Tinkerforge/co2-v2-bricklet/hardware/co2-v2.FCStd

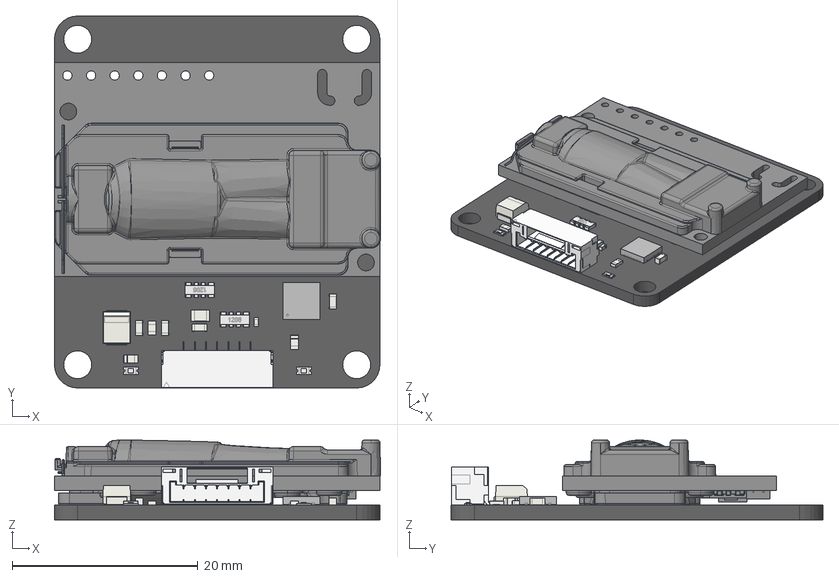
[picture p1: CAD file, 2019-05-15]
hardware/co2-v2.FCStd
35.1 x 40.0 x 8.60 mm
Pcb
R2_R_0603_5BA03E73
R1_R_0603_5BA03E6A
C2_C_0805_5B9F7B11
C3_C_0603_5B9F7B1B
D1_D_0603_blue_5B9F7B59
C1_C_0402_5B9F7B07
C4_C_0603_5B9F7B25
C5_C_0603_5B9F7B2F
C6_C_0603_5B9F7B39
C7_Tantalum_B_3528H21_5B9F9A73
D2_D_0603_blue_5B9F7B6A
L1_R_0603_5B9F7B74
P1_BrickletConn_7pin_5BA0D92D
RP1_R_4x0603_5B9F7BA5
RP3_R_4x0603_5B9F9CCB
U1_QFN-24_4x4mm_Pitch0.5mm_5B9F7BEA
U6_SCD30_5B9F8BF0
