Tinkerforge/co2-v2-bricklet/hardware/co2-v2-schematic.pdf

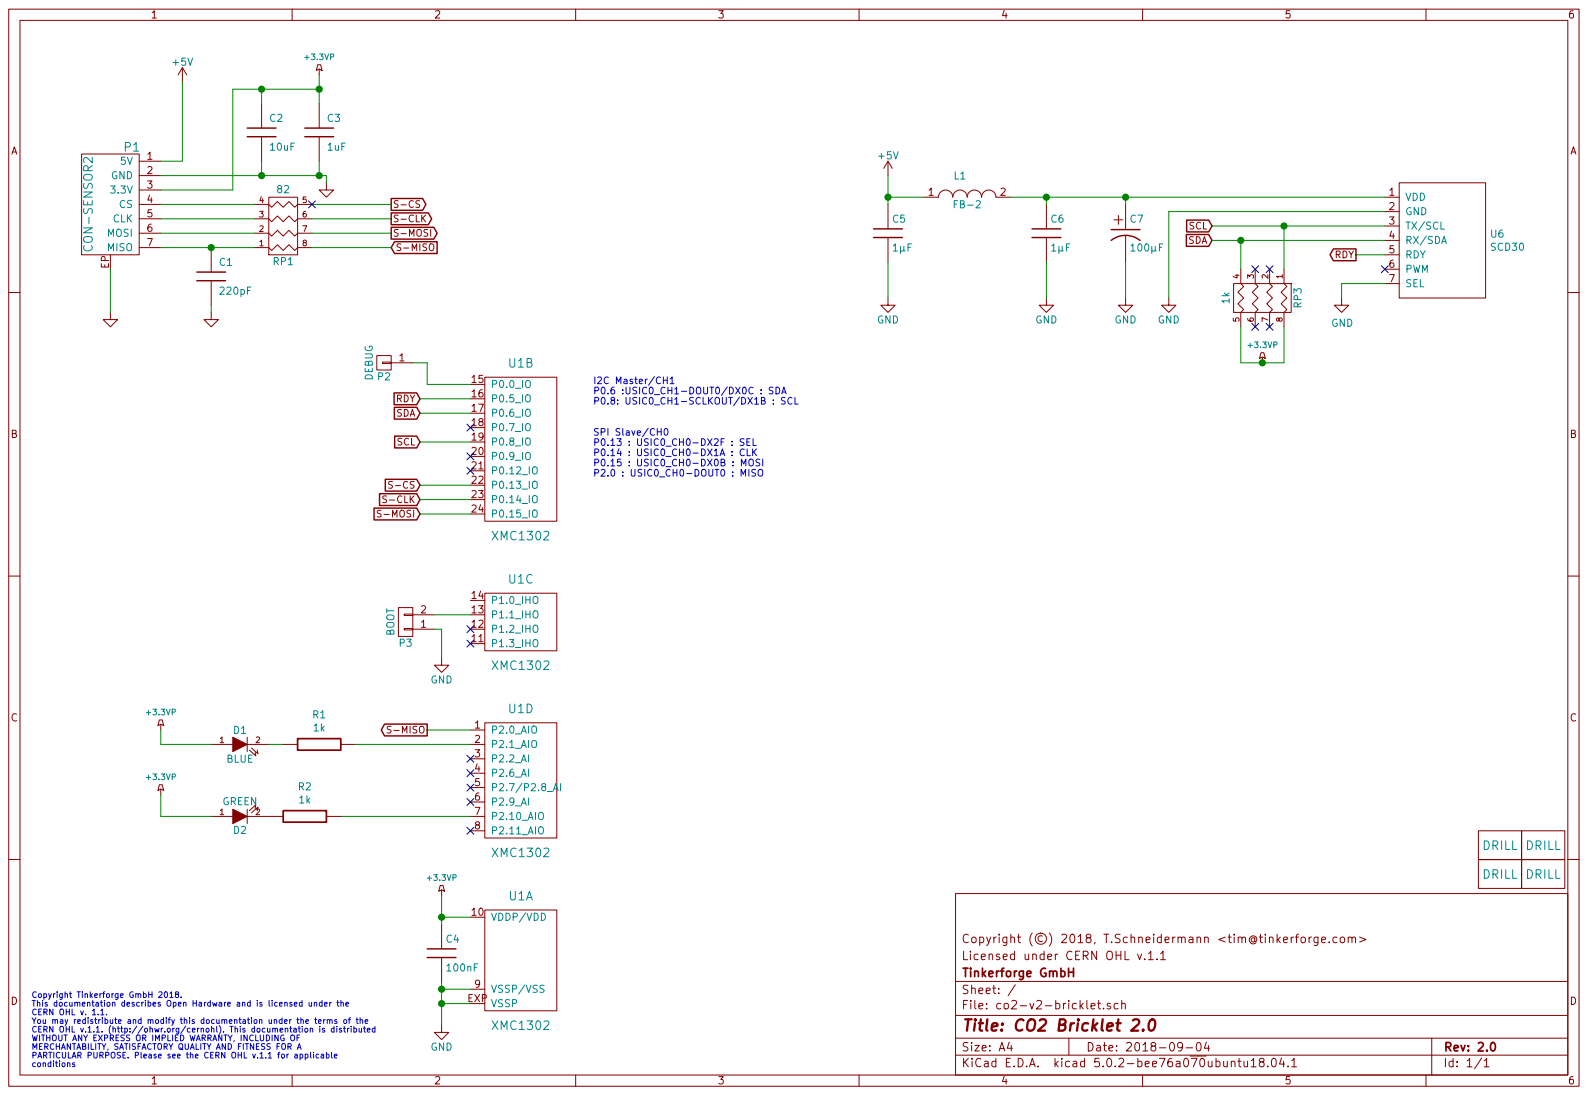
[picture p2: page 1]

SCL SDA GND GND

P0.8: USIC0_CH1-SCLKOUT/DX1B : SCL Copyright Tinkerforge GmbH 2018. This documentation describes Open Hardware and is licensed under the CERN OHL v. 1.1. You may redistribute and modify this documentation under the terms of the CERN OHL v.1.1. (http://ohwr.org/cernohl). This documentation is distributed WITHOUT ANY EXPRESS OR IMPLIED WARRANTY, INCLUDING OF MERCHANTABILITY, SATISFACTORY QUALITY AND FITNESS FOR A

SPI Slave/CH0 P0.13 : USIC0_CH0-DX2F : SEL P0.14 : USIC0_CH0-DX1A : CLK

Licensed under CERN OHL v.1.1 Copyright (©) 2018, T.Schneidermann <tim@tinkerforge.com>

File: co2-v2-bricklet.sch Sheet: / Tinkerforge GmbH

PARTICULAR PURPOSE. Please see the CERN OHL v.1.1 for applicable
conditions
