Tinkerforge/co2-v2-bricklet/hardware/co2-v2.kicad_pcb

## KiCad design hardware/co2-v2.kicad_pcb (2019-05-09)

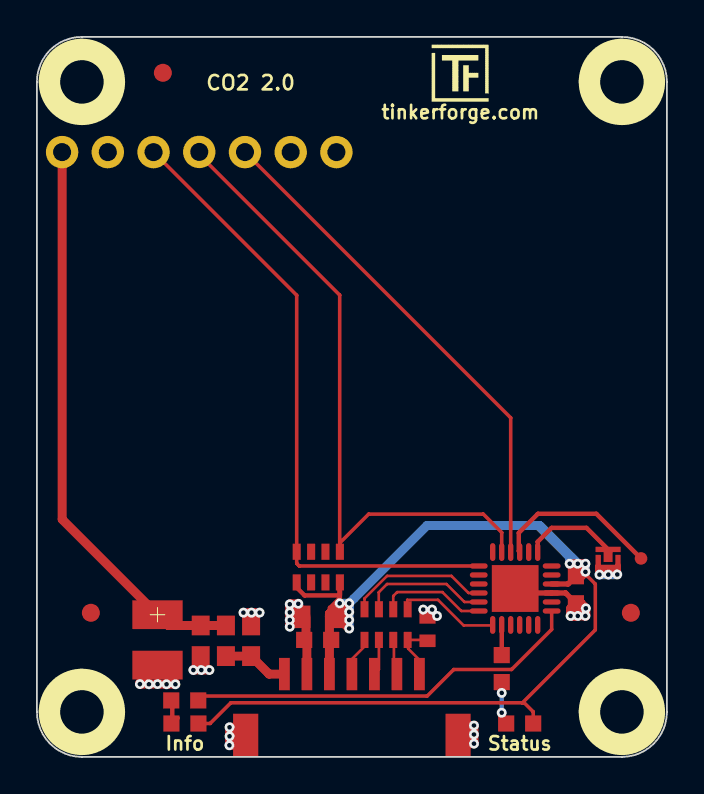
[picture p3: board co2-v2.kicad_pcb from above]

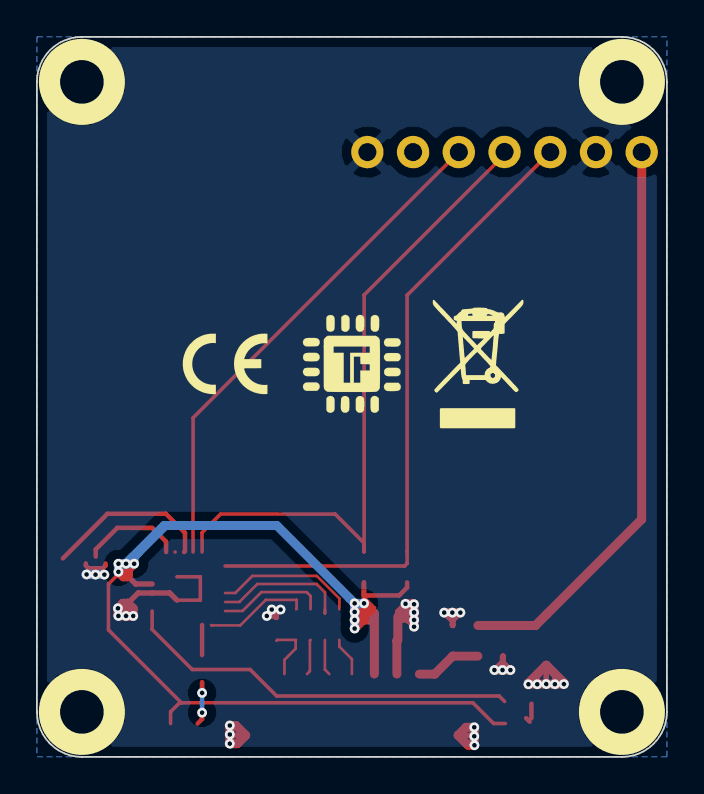
[picture p4: board co2-v2.kicad_pcb from below]

Board: 2 copper layers, 35.0 x 40.0 mm, 28 parts (2 on the bottom side), 21 nets.

Parts:
C1: 220pF; C0402E
C2: 10uF; C0805
C3: 1uF; C0603F
C4: 100nF; C0603F
C5, C6: 1µF; C0603E
C7: 100µF; 3528-21
D1: BLUE; D0603F
D2: GREEN; D0603F
Fiducial_Mark: VAL**; Fiducial_Mark
Fiducial_Mark#2, Fiducial_Mark#3: VAL**; Fiducial_Mark
L1: FB-2; R0603E
P1: CON-SENSOR2
P2: DEBUG; DEBUG_PAD
P3: BOOT; SolderJumper
R1, R2: 1k; R0603F
RP1: 82; 4X0603
RP3: 1k; 4X0603
U1: XMC1302; QFN24-4x4mm-0.5mm
U2, U3, U4, U5: DRILL; DRILL_NP
U6: SCD30
VAL: CE_5mm
VAL#2: WEEE_7mm

Connections:
+3.3VP: C2.1, C3.1, C4.1, D1.1, D2.1, P1.3, RP3.5, RP3.8, U1.10
+5V: C5.1, L1.1, P1.1
GND: C1.2, C2.2, C3.2, C4.2, C5.2, C6.2, C7.2, P1.2, P1.EP, P3.1, U1.9, U1.EXP, U6.2, U6.7
unnamed: C1.1, P1.7, RP1.1
unnamed: C6.1, C7.1, L1.2, U6.1
unnamed: D1.2, R1.2
unnamed: D2.2, R2.2
unnamed: P1.4, RP1.4
unnamed: P1.5, RP1.3
unnamed: P1.6, RP1.2
unnamed: P2.1, U1.15
unnamed: P3.2, U1.13
unnamed: R1.1, U1.2
unnamed: R2.1, U1.7
RDY: U1.16, U6.5
S-CLK: RP1.6, U1.23
S-CS: RP1.5, U1.22
S-MISO: RP1.8, U1.1
S-MOSI: RP1.7, U1.24
SCL: RP3.1, U1.19, U6.3
SDA: RP3.4, U1.17, U6.4
