Tinkerforge/co2-v2-bricklet/(commit log)

2018-09-04 add readme file and add sensor datasheet
2018-09-04 added kicad project
    [co2-v2-bricklet.kicad_pcb, co2-v2-bricklet.sch]
2018-09-04 added schematics
    [co2-v2-bricklet.kicad_pcb, co2-v2-bricklet.sch]
2018-09-07 added symbol and footprint of the SCD30 to the schematic test if the there are correctly saved to the library
    [co2-v2-bricklet.sch]
2018-09-17 changed schematic and pcb design
    [co2-v2-bricklet.kicad_pcb, co2-v2-bricklet.sch]
2018-09-18 final pcb prototype design
    [co2-v2-bricklet.kicad_pcb]
2018-09-18 added "info" to silkscreen and changed the led positions
    [co2-v2-bricklet.kicad_pcb]
2018-09-18 changed led pin and routed new trace on front
    [co2-v2-bricklet.kicad_pcb, co2-v2-bricklet.sch]
2018-09-25 more spi spacing
    [co2-v2-bricklet.kicad_pcb]
2019-01-17 fix grid origin, change name
    [co2-v2-bricklet.kicad_pcb]
2019-02-15 Add initial implementation of CO2 V2 firmware
    [cmake_config_custom.txt]
2019-02-18 Fix air pressure invalid parameter handling
    [communication.c]
2019-02-18 Fix temperature offset bit shifting
    [scd30.c]
2019-02-22 changed processor to XMC1302
    [co2-v2-bricklet.kicad_pcb, co2-v2-bricklet.sch]
2019-05-09 add schematic
    [co2-v2-bricklet.kicad_pcb]
2019-05-15 fix file names
    [co2-v2.kicad_pcb, co2-v2.sch]
2019-05-15 add 3d data
    [co2-v2.FCStd]
2019-08-22 c: Adapt to bindings changes
    [example_callback.c]
2019-08-28 Improve I2C error handling
    In case of timeout or other error we now completely reconfigure
    the I2C hardware unit and also the SCD30 sensor.
    [config.h, scd30.c]
2020-08-31 uc: Use fixed-with placeholders in format strings.
    [example_callback.c, example_simple.c]
2020-09-02 uc: Add example driver note.
2020-10-16 uc: Fix divisor type.
    [example_callback.c]
2021-10-25 Update KiCad link
    https://www.kicad.org/blog/2021/10/Avoid-links-to-former-kicad-domain/
2022-04-27 uc: Adapt to bindings changes
    [example_callback.c, example_simple.c]
