Tinkerforge/co2-v2-bricklet/(notices)

Notices in the files:
hardware/co2-v2.kicad_pcb:
Copyright (©) 2015, T.Schneidermann
